coopjz/FOC_Control_Boards/gen2/ELEC3300_DEMO.jpg

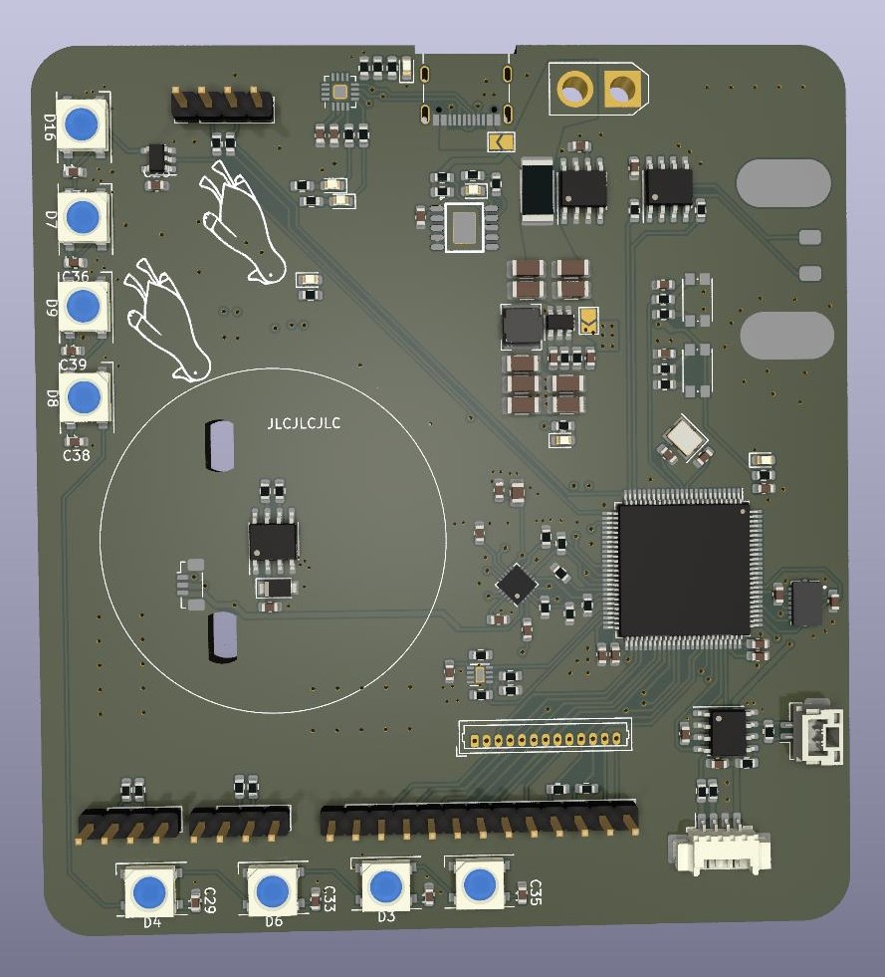
gen2/ELEC3300_DEMO.jpg
