coopjz/FOC_Control_Boards/README.md

# FOC_Control_Boards
1. generation one: g431
2. generation two: f407
- BUGS: BUCK feedback
- BUGS: Hall sensor MISO

## SoftWare
All the firmware :
url{https://github.com/coopjz/ELEC3300-Firmware }

**Author: Ed, Cooper**

**Thanks to:** Ethan, eassse, Jason
