coopjz/FOC_Control_Boards/3finaldemo.pdf

Design Showcase | UI Design | FOC Algorithms | RTOS!

# A FOC Controlled Smart Knob

# WANG Junzhe, ZOU Hetai

## ELEC3300 Group 5

# May 8, 2023

# Design Showcase Schematics and PCB

# UI Design

# FOC Algorithms

# RTOS!

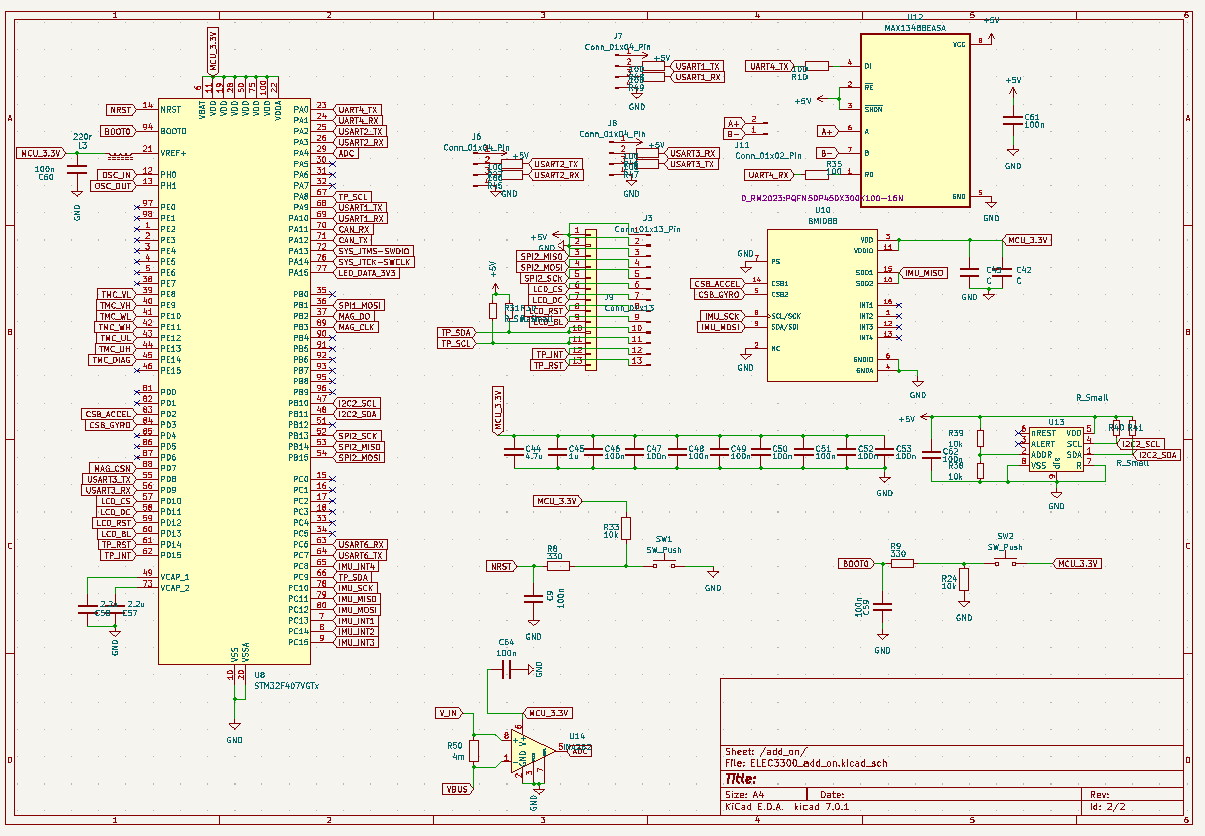
[picture p3: figure]

## Figure: schematic 1

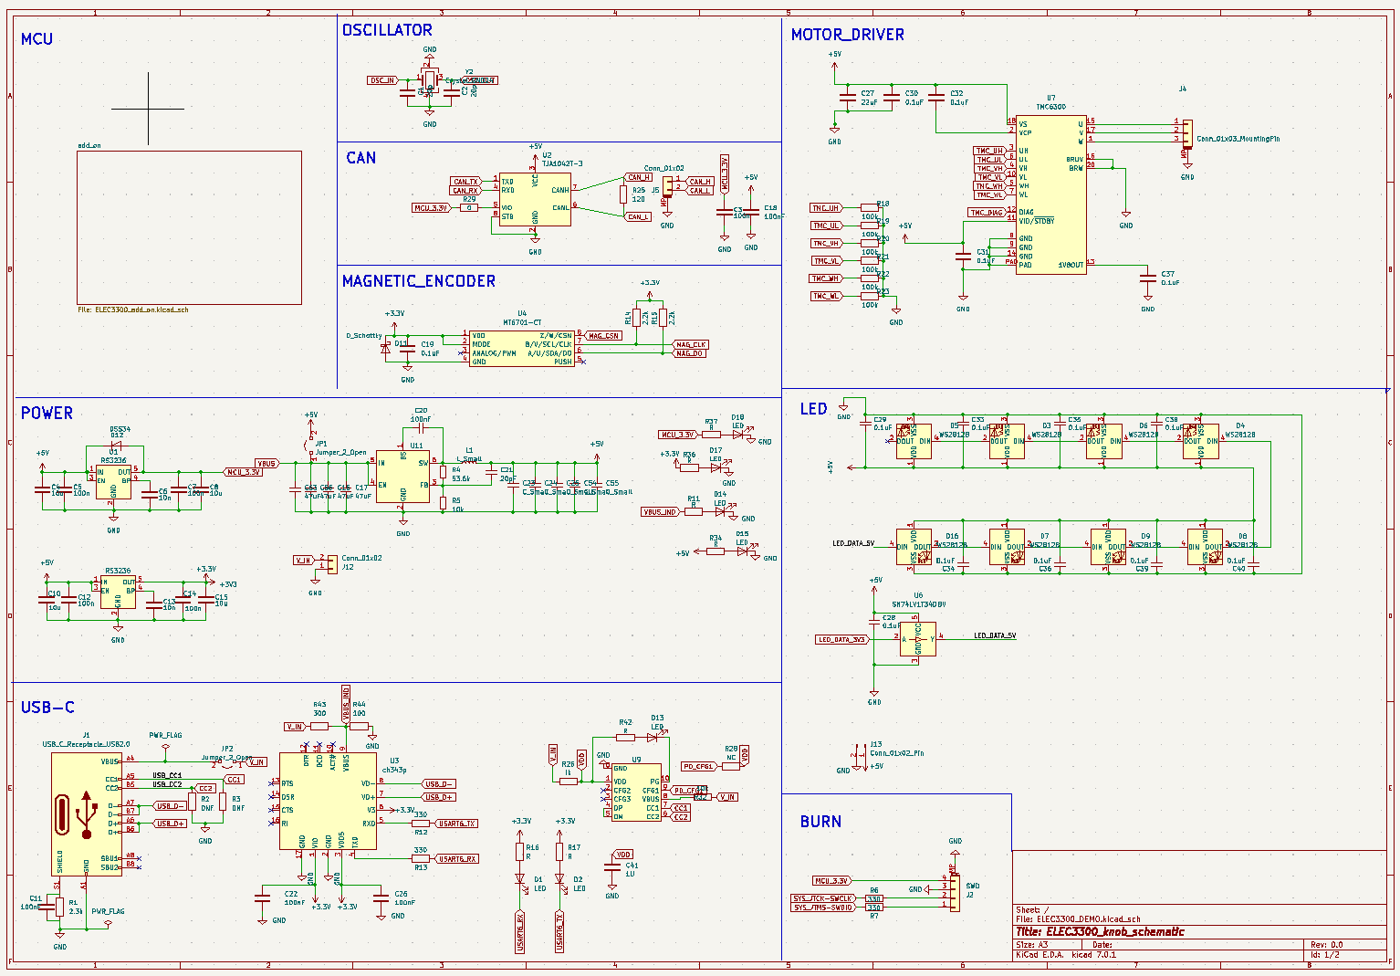
[picture p4: figure]

## Figure: schematic 2

# PCB layout

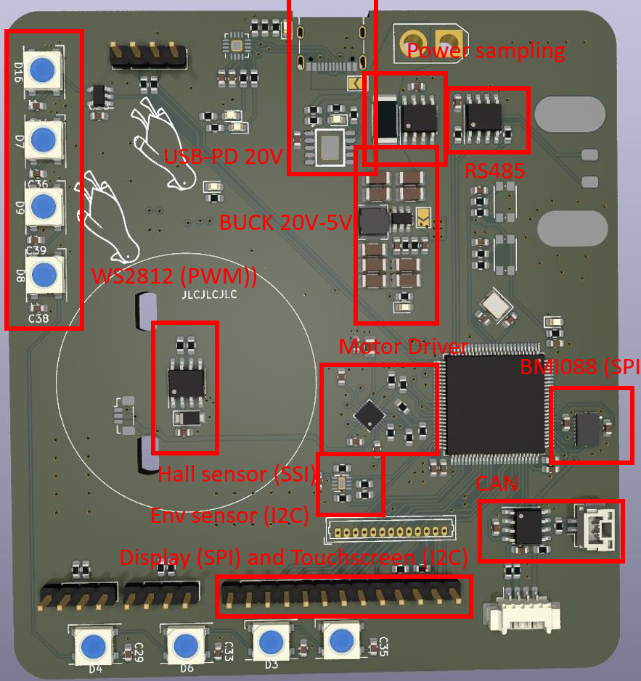
[picture p5: figure]

## Figure: PCB Layout

## •FOC Algorithm Close loop Controlled Motor as knob (Algorithm)

•Magnetic Hall effect sensor feedback | (SPI)
•Brushless DC motor driver | (Half Bridges Driver)
•Implement our own ESC | (SVPWM)
•Bluetooth and usb-ttl controlled | (UART)

## •Usb-C PD power delivery with buck converter (GPIO)

•Power adc sampling | (ADC)
•WS2812 LEDs | (PWM)
•IMU wake detection | (SPI)
•LCD touch screen | (SPI + I2C)
•Smooth and Fast Refresh UI | (Double-Buffer DMA)
•Humidity and Temperature Sensor | (I2C)

# UI Design

# § DMA double buffer to increase frame rate § Async parallel display flush

## § Rendering complete will trigger a callback § DMA will be used to flush to the display afterward

# § LVGL UI elements design

# FOC

# Where is ESC for the knob? We implement our own ESC using Field Oriented Control!

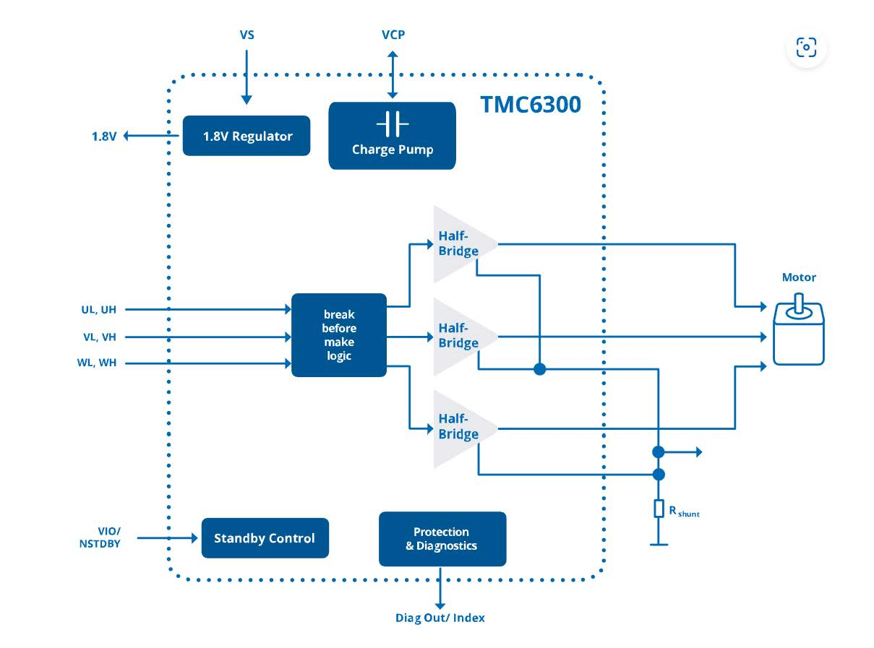
[picture p6: figure]

# Sine PWM (Good)

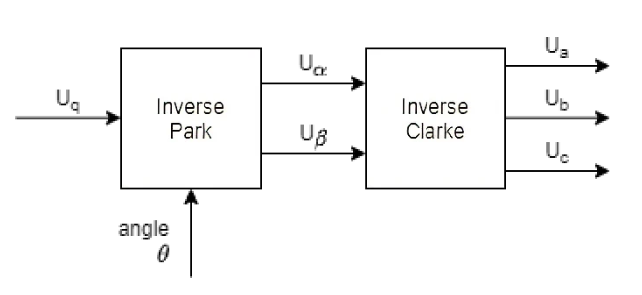
[picture p7: figure]

## Figure: sine pwm

# Sine PWM (Good)

# 1. Inverse Park transformation

# § Uα = ´Uqsin(θ) § Uβ = Uqcos(θ)

# 2. Inverse Clarke transformation

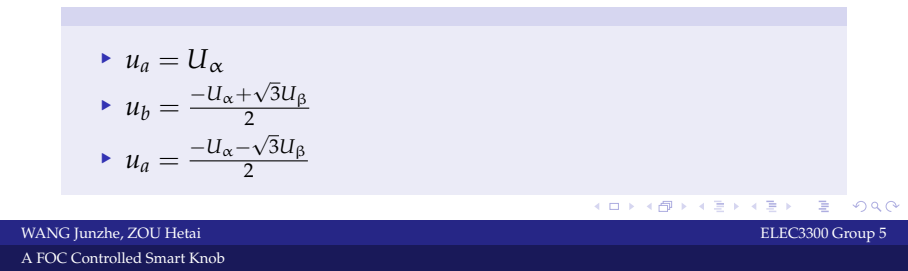
[picture p8: figure]

# to SV PWM (Better)

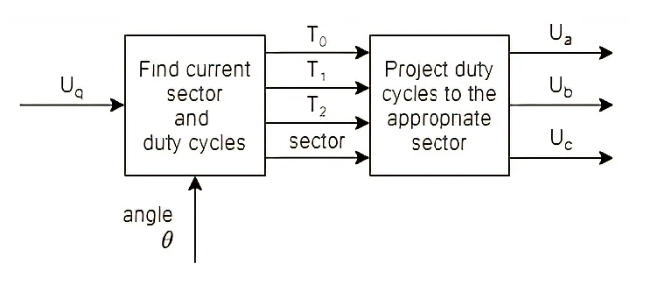
[picture p9: figure]

## Figure: SV pwm

# to SV PWM (Better)

# § space vector modulation

§ s =

X

3
π

\
+ θ

§ T1 =

?

# 3sin(s

3
π ´ θ)

§ T2 =

?

# 3sin(θ ´ (s ´ 1)

3
π

)

## § T0 = 1 ´ T1 ´ T2

# FreeRTOS

# § FreeRTOS to schedule the tasks

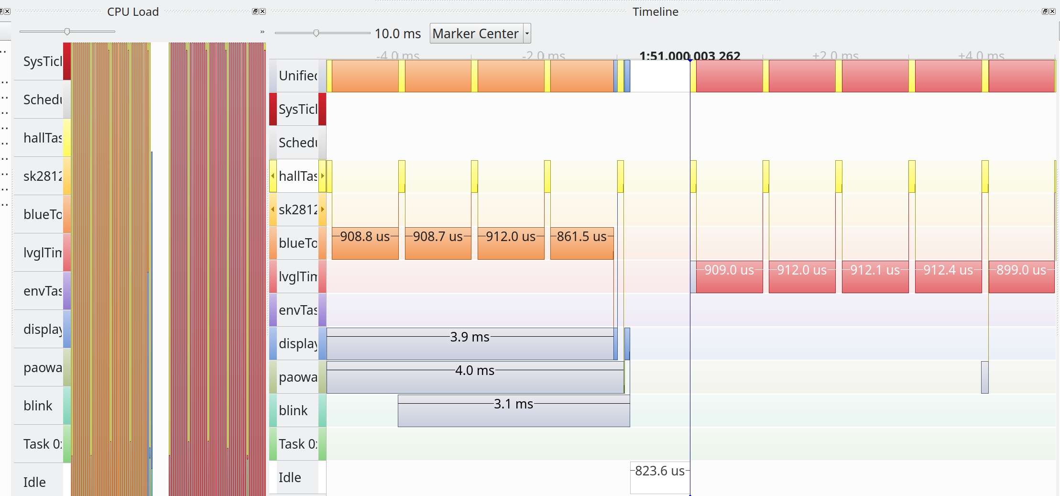
[picture p10: figure]

## Figure: FreeRTOS Scheduler

# That would be all

# - Thank you!
