coopjz/FOC_Control_Boards/gen2/BMI088.step

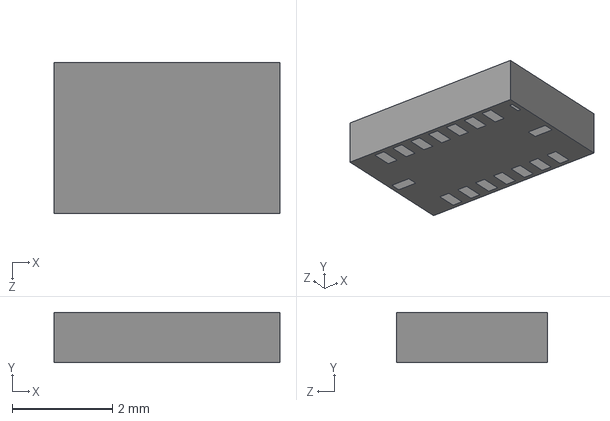
[picture p11: CAD file, 2023-05-09]
gen2/BMI088.step
4.50 x 1.00 x 3.00 mm
