coopjz/FOC_Control_Boards/gen2/MPU-6500/MPU-6500.step

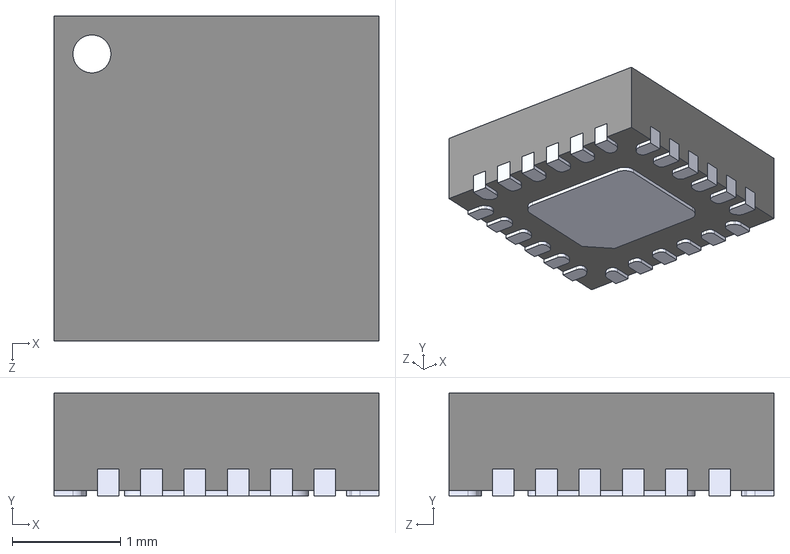
[picture p12: CAD file, 2023-05-09]
gen2/MPU-6500/MPU-6500.step
3.00 x 0.95 x 3.00 mm
