coopjz/FOC_Control_Boards/gen2/ELEC3300_DEMO.kicad_pcb

## KiCad design gen2/ELEC3300_DEMO.kicad_pcb (2023-05-09)

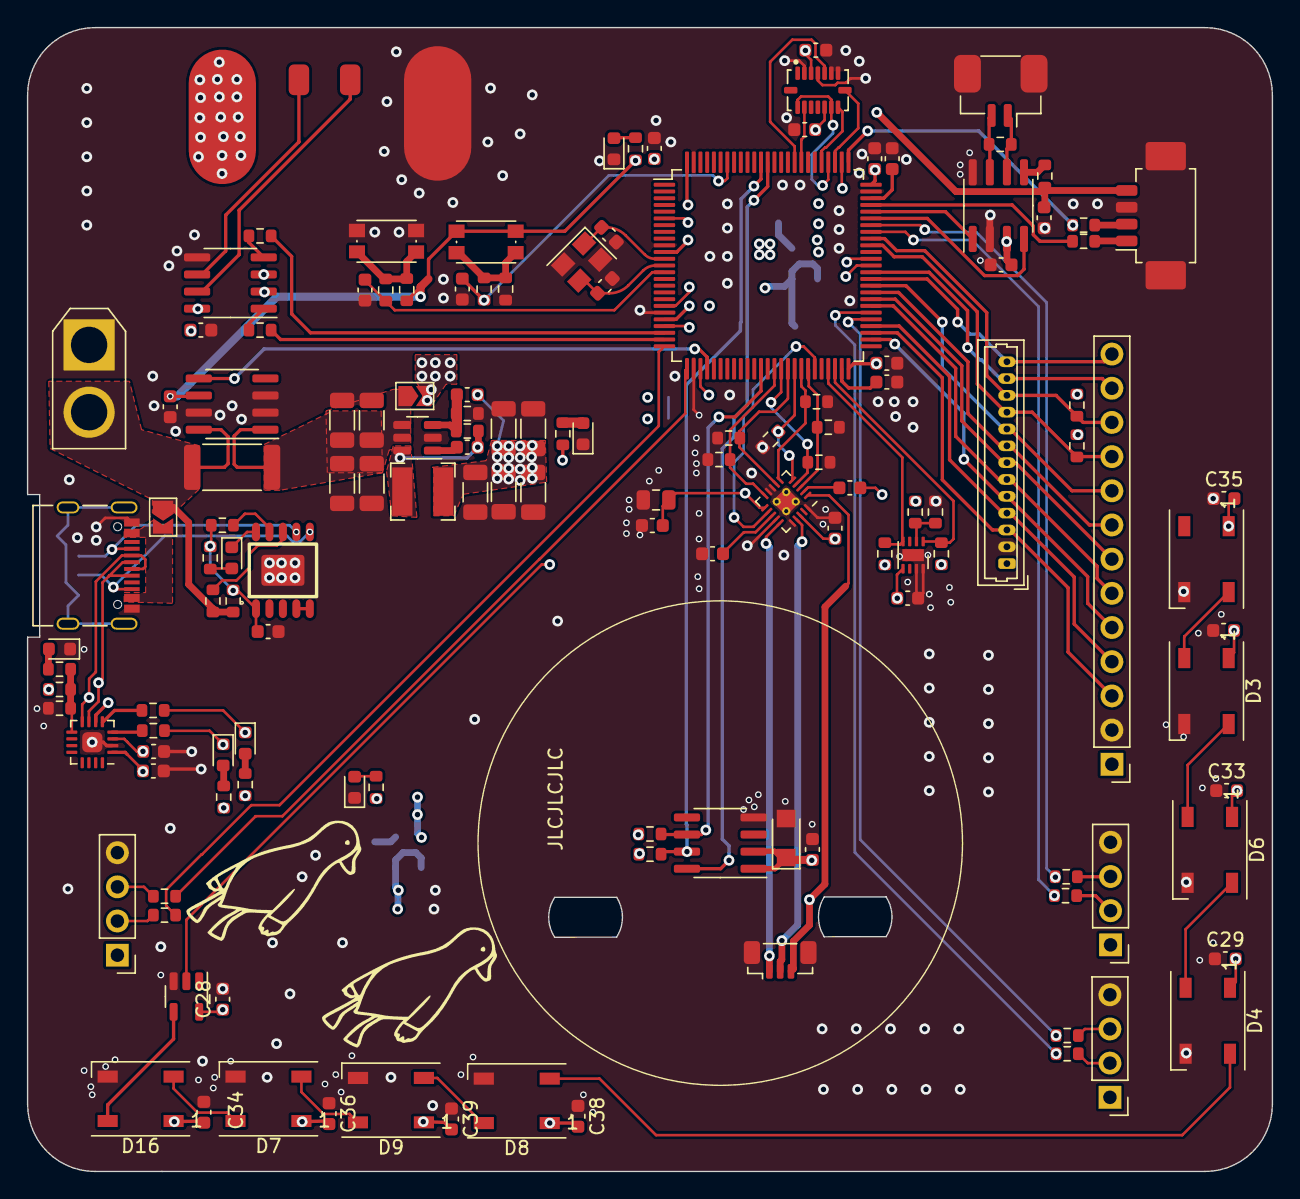
[picture p13: board gen2/ELEC3300_DEMO.kicad_pcb from above]

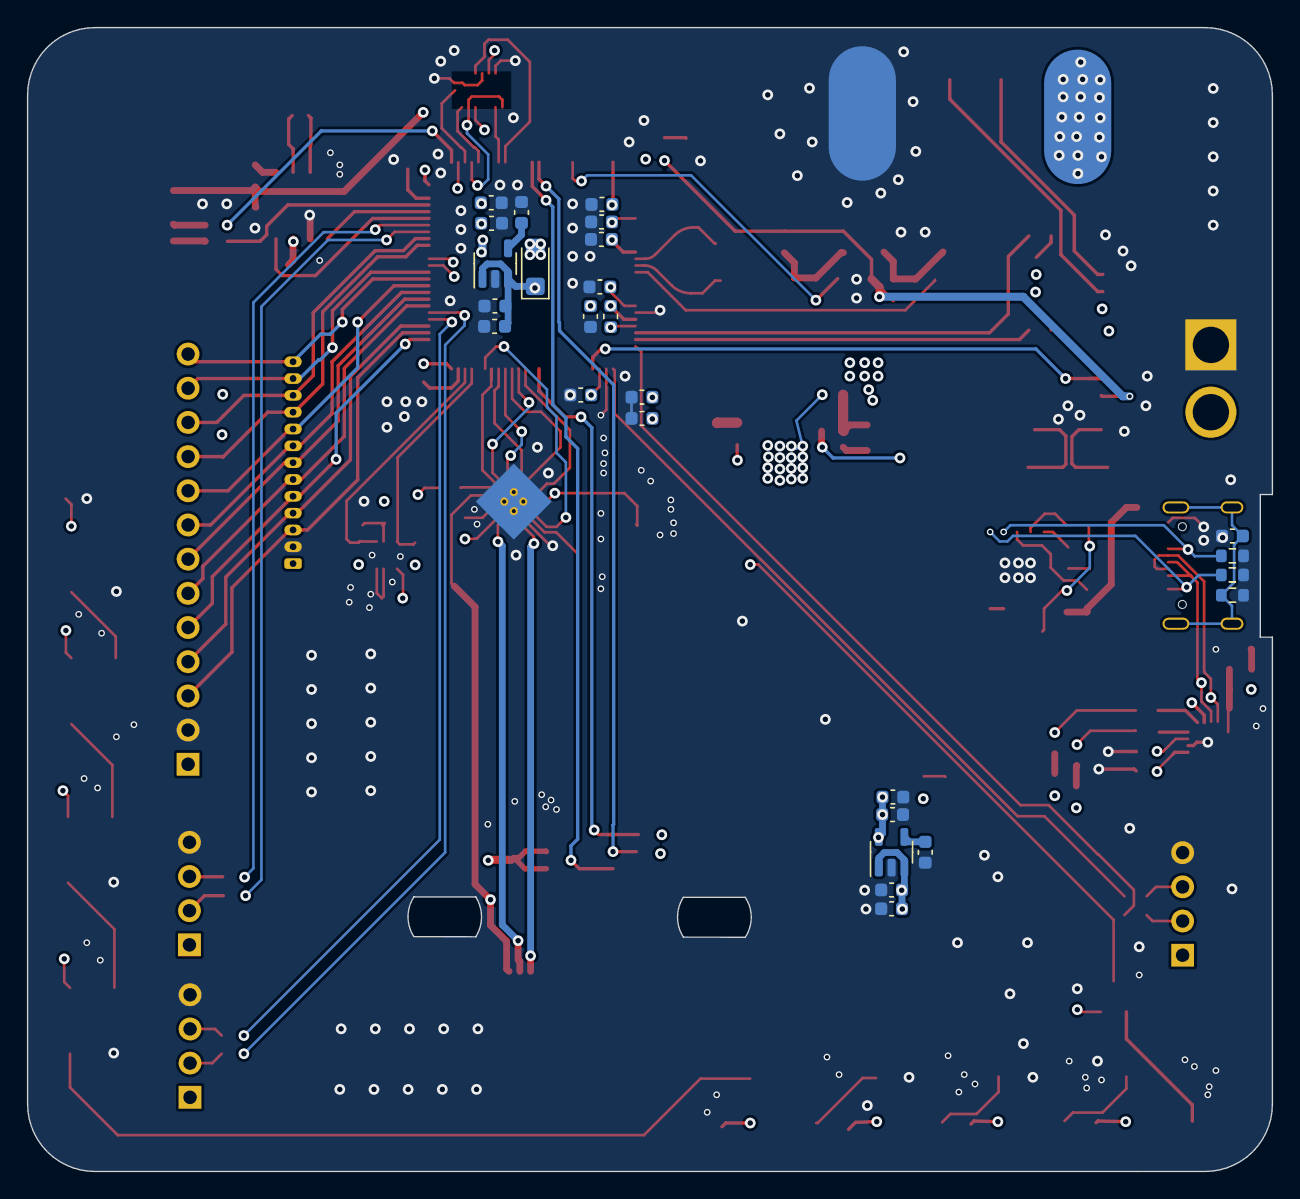
[picture p14: board gen2/ELEC3300_DEMO.kicad_pcb from below]

Board: 4 copper layers, 92.5 x 85.0 mm, 164 parts (26 on the bottom side), 114 nets.

Parts:
C1, C2: 20p; C_0603_1608Metric
C3, C5, C7, C9, C12, C14, C46, C47, C48, C49, C50, C51, C52, C53, C59, C60, C61, C62, C64: 100n; C_0603_1608Metric
C4, C8, C10, C15: 10u; C_0603_1608Metric
C6, C13: 10n; C_0603_1608Metric
C11, C18, C20, C22, C26: 100nF; C_0603_1608Metric
C16, C17, C56, C63: 47uF; C_1206_3216Metric
C19, C28, C29, C30, C31, C32, C33, C34, C35, C36, C37, C38, C39, C40: 0.1uF; C_0603_1608Metric
C21: 20pF; C_0603_1608Metric
C23, C24, C25, C54, C55: C_Small; C_1206_3216Metric
C27: 22uF; C_0805_2012Metric
C41: 1U; C_0603_1608Metric
C42, C43: C; C_0603_1608Metric
C44: 4.7u; C_0603_1608Metric
C45: 1u; C_0603_1608Metric
C57, C58: 2.2u; C_0603_1608Metric
D1, D2, D13, D14, D15, D17, D18: LED; LED_0603_1608Metric
D3, D4, D5, D6, D7, D8, D9, D16: WS2812B; LED_WS2812B_PLCC4_5.0x5.0mm_P3.2mm
D11: D_Schottky; D_SMF
D12: DSS34; D_SMF
J1: USB_C_Receptacle_USB2.0; USB_C_Receptacle_Palconn_UTC16-G
J2: SWD; Molex_PicoBlade_53261-0471_1x04-1MP_P1.25mm_Horizontal
J3: Conn_01x13_Pin; PinHeader_1x13_P2.54mm_Vertical
J4: Conn_01x03_MountingPin; JST_SUR_BM03B-SURS-TF_1x03-1MP_P0.80mm_Vertical
J5: Conn_01x02; GH_1x02
J6, J7, J8: Conn_01x04_Pin; PinHeader_1x04_P2.54mm_Vertical
J9: Conn_01x13; Molex_PicoBlade_53047-1310_1x13_P1.25mm_Vertical
J11: Conn_01x02_Pin; padSmall2
J12: Conn_01x02; AMASS_XT30U-M_1x02_P5.0mm_Vertical
J13: Conn_01x02_Pin; pads2
JP1, JP2: Jumper_2_Open; SolderJumper-2_P1.3mm_Open_TrianglePad1.0x1.5mm
L1: L_Small; L_Bourns-SRN4018
L3: 220r; L_0603_1608Metric
R1: 2.3k; R_0603_1608Metric
R2, R3: 5.1k; R_0603_1608Metric
R4: 53.6k; R_0603_1608Metric
R5, R24, R32, R33, R38, R39: 10k; R_0603_1608Metric
R6, R7, R8, R9, R12, R13: 330; R_0603_1608Metric
R10, R27, R35, R44, R45, R46, R47, R48, R49: 100; R_0603_1608Metric
R11, R16, R17, R34, R36, R37, R42: R; R_0603_1608Metric
R14, R15: 2.2k; R_0603_1608Metric
R18, R19, R20, R21, R22, R23: 100k; R_0603_1608Metric
R25: 120; R_0603_1608Metric
R26: Ik; R_0603_1608Metric
R28: NC; R_0603_1608Metric
R29: 0; R_0603_1608Metric
R30, R31, R40, R41: R_Small; R_0603_1608Metric
R43: 300; R_0603_1608Metric
R50: 4m; R_2512_6332Metric
SW1, SW2: SW_Push; SW_Push_1P1T_NO_CK_KMR2
U1, U5: RS3236; SOT-23-5
U2: TJA1042T-3; SOIC-8_3.9x4.9mm_P1.27mm
U3: ch343p; QFN-16-1EP_3x3mm_P0.5mm_EP1.7x1.7mm
U4: MT6701-CT; SOIC-8_3.9x4.9mm_P1.27mm
U6: SN74LV1T34DBV; SOT-23-5
U7: TMC6300; QFN-20-1EP_3x3mm_P0.4mm_EP1.65x1.65mm_ThermalVias_LargerVia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
U8: STM32F407VGTx; LQFP-100_14x14mm_P0.5mm
U9: ESSOP-10
U10: BMI088; PQFN50P450X300X100-16N
U11: SOT-23-6
U12: MAX13488EASA; SOIC-8_3.9x4.9mm_P1.27mm
U13: DFN-8-1EP_2x2mm_P0.5mm_EP0.9x1.6mm
U14: INA282; SOIC-8_3.9x4.9mm_P1.27mm
Y2: Crystal_GND24; Crystal_SMD_3225-4Pin_3.2x2.5mm

Connections:
+3.3V: C14.1, C15.1, C19.1, C22.1, C26.1, D11.1 (K), R14.2, R15.2, R16.2, R17.2, R36.1, U3.1 (VIO), U3.3 (VDD5), U3.6 (V3), U4.1 (VDD), U4.2 (MODE), U5.5 (OUT)
+5V: C4.1, C5.1, C10.1, C12.1, C18.1, C21.2, C23.2, C24.2, C25.2, C27.1, C28.1, C29.2, C30.1, C31.1, C32.1, C33.2, C34.2, C35.2, C36.2, C38.2, C39.2, C40.2, C54.2, C55.2, C61.1, C62.1, D3.1 (VDD), D4.1 (VDD), D5.1 (VDD), D6.1 (VDD), D7.1 (VDD), D8.1 (VDD), D9.1 (VDD), D12.1 (K), D16.1 (VDD), J3.1, J6.1, J7.1, J8.1, J9.1, J13.1, JP1.2 (B), L1.2, R30.1, R31.1, R34.1, R39.2, R40.1, R41.1, U1.1 (IN), U1.3 (EN), U2.3 (VCC), U5.1 (IN), U5.3 (EN), U6.5 (VCC), U7.11 (VIO/~STDBY), U7.18 (VS), U12.2 (~RE), U12.3 (~SHDN), U12.8 (VCC), U13.5 (VDD)
/LED_DATA_5V: D16.4 (DIN), U6.4 (Y)
A+: J11.2, U12.6 (A)
ADC: U8.29 (PA4), U14.5
B-: J11.1, U12.7 (B)
BOOT0: C59.1, R9.2, U8.94 (BOOT0)
CAN_H: J5.1, R25.1, U2.7 (CANH)
CAN_L: J5.2, R25.2, U2.6 (CANL)
CAN_RX: U2.4 (RXD), U8.70 (PA11)
CAN_TX: U2.1 (TXD), U8.71 (PA12)
CC1: J1.A5 (CC1), R3.1, U9.7 (CC1)
CC2: J1.B5 (CC2), R2.1, U9.6 (CC2)
CSB_ACCEL: U8.83 (PD2), U10.14 (CSB1)
CSB_GYRO: U8.84 (PD3), U10.5 (CSB2)
GND: C1.1, C2.1, C3.2, C4.2, C5.2, C6.2, C7.2, C8.2, C9.1, C10.2, C11.2, C12.2, C13.2, C14.2, C15.2, C16.1, C17.1, C18.2, C19.2, C22.2, C23.1, C24.1, C25.1, C26.2, C27.2, C28.2, C29.1, C30.2, C31.2, C33.1, C34.1, C35.1, C36.1, C37.2, C38.1, C39.1, C40.1, C41.2, C42.1, C43.1, C44.2, C45.2, C46.2, C47.2, C48.2, C49.2, C50.2, C51.2, C52.2, C53.2, C54.1, C55.1, C56.1, C57.1, C58.1, C59.2, C60.1, C61.2, C62.2, C63.1, C64.2, D3.3 (VSS), D4.3 (VSS), D5.3 (VSS), D6.3 (VSS), D7.3 (VSS), D8.3 (VSS), D9.3 (VSS), D11.2 (A), D14.1 (K), D15.1 (K), D16.3 (VSS), D17.1 (K), D18.1 (K), J1.A1 (GND), J1.A12 (GND), J1.B1 (GND), J1.B12 (GND), J2.3, J2.MP (MountPin), J3.2, J4.MP (MountPin), J5.MP (MountPin), J6.4, J7.4, J8.4, J9.2, J12.1, J13.2, R1.2, R2.2, R3.2, R5.2, R18.2, R19.2, R20.2, R21.2, R22.2, R23.2, R24.2, R38.1, R44.2, SW1.2, U1.2 (GND), U2.2 (GND), U2.8 (STB), U3.2 (GND), U3.17 (GND), U4.4 (GND), U5.2 (GND), U6.3 (GND), U7.8 (GND), U7.9 (GND), U7.14 (GND), U7.16 (BRUV), U7.20 (BRW), U7.PAD, U8.10 (VSS), U8.20 (VSSA), U8.27 (VSS), U8.74 (VSS), U8.99 (VSS), U9.0 (GND), U10.2 (NC), U10.4 (GNDA), U10.6 (GNDIO), U10.7 (PS), U11.2 (GND), U12.5 (GND), U13.7 (R), U13.8 (VSS), U13.9 (die), U14.2 (GND), U14.3 (REF2), U14.7 (REF1), Y2.2, Y2.4
I2C2_SCL: R40.2, U8.47 (PB10), U13.4 (SCL)
I2C2_SDA: R41.2, U8.48 (PB11), U13.1 (SDA)
IMU_MISO: U8.79 (PC11), U10.10 (SDO2), U10.15 (SDO1)
IMU_MOSI: U8.80 (PC12), U10.9 (SDA/SDI)
IMU_SCK: U8.78 (PC10), U10.8 (SCL/SCK)
LCD_BL: J3.9, J9.9, U8.60 (PD13)
LCD_CS: J3.6, J9.6, U8.57 (PD10)
LCD_DC: J3.7, J9.7, U8.58 (PD11)
LCD_RST: J3.8, J9.8, U8.59 (PD12)
LED_DATA_3V3: U6.2 (A), U8.77 (PA15)
MAG_CLK: R14.1, U4.7 (B/V/SCL/CLK), U8.89 (PB3)
MAG_CSN: U4.8 (Z/W/CSN), U8.88 (PD7)
MAG_DO: R15.1, U4.6 (A/U/SDA/DO), U8.37 (PB2)
MCU_3.3V: C3.1, C7.1, C8.1, C42.2, C43.2, C44.1, C45.1, C46.1, C47.1, C48.1, C49.1, C50.1, C51.1, C52.1, C53.1, C60.2, C64.1, D12.2 (A), J2.4, L3.2, R29.1, R33.1, R37.1, SW2.2, U1.5 (OUT), U8.6 (VBAT), U8.11 (VDD), U8.19 (VDD), U8.22 (VDDA), U8.28 (VDD), U8.50 (VDD), U8.75 (VDD), U8.100 (VDD), U10.3 (VDD), U10.11 (VDDIO), U14.6 (V+)
NRST: C9.2, R8.2, U8.14 (NRST)
unnamed: D1.2 (A), R16.1
unnamed: D2.2 (A), R17.1
unnamed: D3.4 (DIN), D6.2 (DOUT)
unnamed: D3.2 (DOUT), D5.4 (DIN)
unnamed: D4.4 (DIN), D8.2 (DOUT)
unnamed: D4.2 (DOUT), D6.4 (DIN)
unnamed: D7.2 (DOUT), D9.4 (DIN)
unnamed: D8.4 (DIN), D9.2 (DOUT)
unnamed: D13.2 (A), R42.2
unnamed: D13.1 (K), U9.10 (PG)
unnamed: D14.2 (A), R11.2
unnamed: D15.2 (A), R34.2
unnamed: D7.4 (DIN), D16.2 (DOUT)
unnamed: D17.2 (A), R36.2
unnamed: D18.2 (A), R37.2
unnamed: C11.1, J1.S1 (SHIELD), R1.1
unnamed: J2.1, R7.2
unnamed: J2.2, R6.2
unnamed: J4.1, U7.15 (U)
unnamed: J4.2, U7.17 (V)
unnamed: J4.3, U7.1 (W)
unnamed: J6.2, R27.2
unnamed: J6.3, R45.2
unnamed: J7.2, R48.2
unnamed: J7.3, R49.2
unnamed: J8.2, R46.2
unnamed: J8.3, R47.2
unnamed: J1.A4 (VBUS), J1.A9 (VBUS), J1.B4 (VBUS), J1.B9 (VBUS), JP2.2 (B)
unnamed: R9.1, R24.1, SW2.1
unnamed: R8.1, R33.2, SW1.1
unnamed: C6.1, U1.4 (BP)
unnamed: R29.2, U2.5 (VIO)
unnamed: R12.1, U3.5 (RXD)
unnamed: R13.1, U3.4 (TXD)
unnamed: C13.1, U5.4 (BP)
unnamed: C37.1, U7.13 (1V8OUT)
unnamed: C32.2, U7.2 (VCP)
unnamed: C58.2, U8.49 (VCAP_1)
unnamed: C57.2, U8.73 (VCAP_2)
unnamed: L3.1, U8.21 (VREF+)
unnamed: U9.4 (DP), U9.5 (DM)
unnamed: R32.1, U9.8 (VBUS)
unnamed: C20.1, U11.1 (BS)
unnamed: C21.1, R4.2, R5.1, U11.3 (FB)
unnamed: C20.2, L1.1, R4.1, U11.6 (SW)
unnamed: R10.1, U12.4 (DI)
unnamed: R35.2, U12.1 (RO)
unnamed: R38.2, R39.1, U13.2 (ADDR)
OSC_IN: C1.2, U8.12 (PH0), Y2.1
OSC_OUT: C2.2, U8.13 (PH1), Y2.3
PD_CFG1: R28.2, U9.9 (CFG1)
SPI2_MISO: J3.3, J9.3, U8.53 (PB14)
SPI2_MOSI: J3.4, J9.4, U8.54 (PB15)
SPI2_SCK: J3.5, J9.5, U8.52 (PB13)
SYS_JTCK-SWCLK: R6.1, U8.76 (PA14)
SYS_JTMS-SWDIO: R7.1, U8.72 (PA13)
TMC_DIAG: U7.12 (DIAG), U8.45 (PE14)
TMC_UH: R18.1, U7.3 (UH), U8.44 (PE13)
TMC_UL: R19.1, U7.6 (UL), U8.43 (PE12)
TMC_VH: R20.1, U7.4 (VH), U8.40 (PE9)
TMC_VL: R21.1, U7.10 (VL), U8.39 (PE8)
TMC_WH: R22.1, U7.5 (WH), U8.42 (PE11)
TMC_WL: R23.1, U7.7 (WL), U8.41 (PE10)
TP_INT: J3.12, J9.12, U8.62 (PD15)
TP_RST: J3.13, J9.13, U8.61 (PD14)
TP_SCL: J3.11, J9.11, R31.2, U8.67 (PA8)
TP_SDA: J3.10, J9.10, R30.2, U8.66 (PC9)
UART4_RX: R35.1, U8.24 (PA1)
UART4_TX: R10.2, U8.23 (PA0)
USART1_RX: R49.1, U8.69 (PA10)
USART1_TX: R48.1, U8.68 (PA9)
USART2_RX: R45.1, U8.26 (PA3)
USART2_TX: R27.1, U8.25 (PA2)
USART3_RX: R46.1, U8.56 (PD9)
USART3_TX: R47.1, U8.55 (PD8)
USART6_RX: D1.1 (K), R13.2, U8.63 (PC6)
USART6_TX: D2.1 (K), R12.2, U8.64 (PC7)
USB_D+: J1.A6 (D+), J1.B6 (D+), U3.7 (VD+)
USB_D-: J1.A7 (D-), J1.B7 (D-), U3.8 (VD-)
VBUS: C16.2, C17.2, C56.2, C63.2, JP1.1 (A), R50.2, U11.4 (EN), U11.5 (IN), U14.1 (-)
VBUS_IND: R11.1, R43.2, R44.1, U3.9 (VBUS)
VDD: C41.1, R26.1, R28.1, R42.1, U9.1 (VDD)
V_IN: J12.2, JP2.1 (A), R26.2, R32.2, R43.1, R50.1, U14.8 (+)
