coopjz/FOC_Control_Boards/gen1/ELEC3300_DEMO.kicad_pcb

## KiCad design gen1/ELEC3300_DEMO.kicad_pcb (2023-05-09, an earlier design)

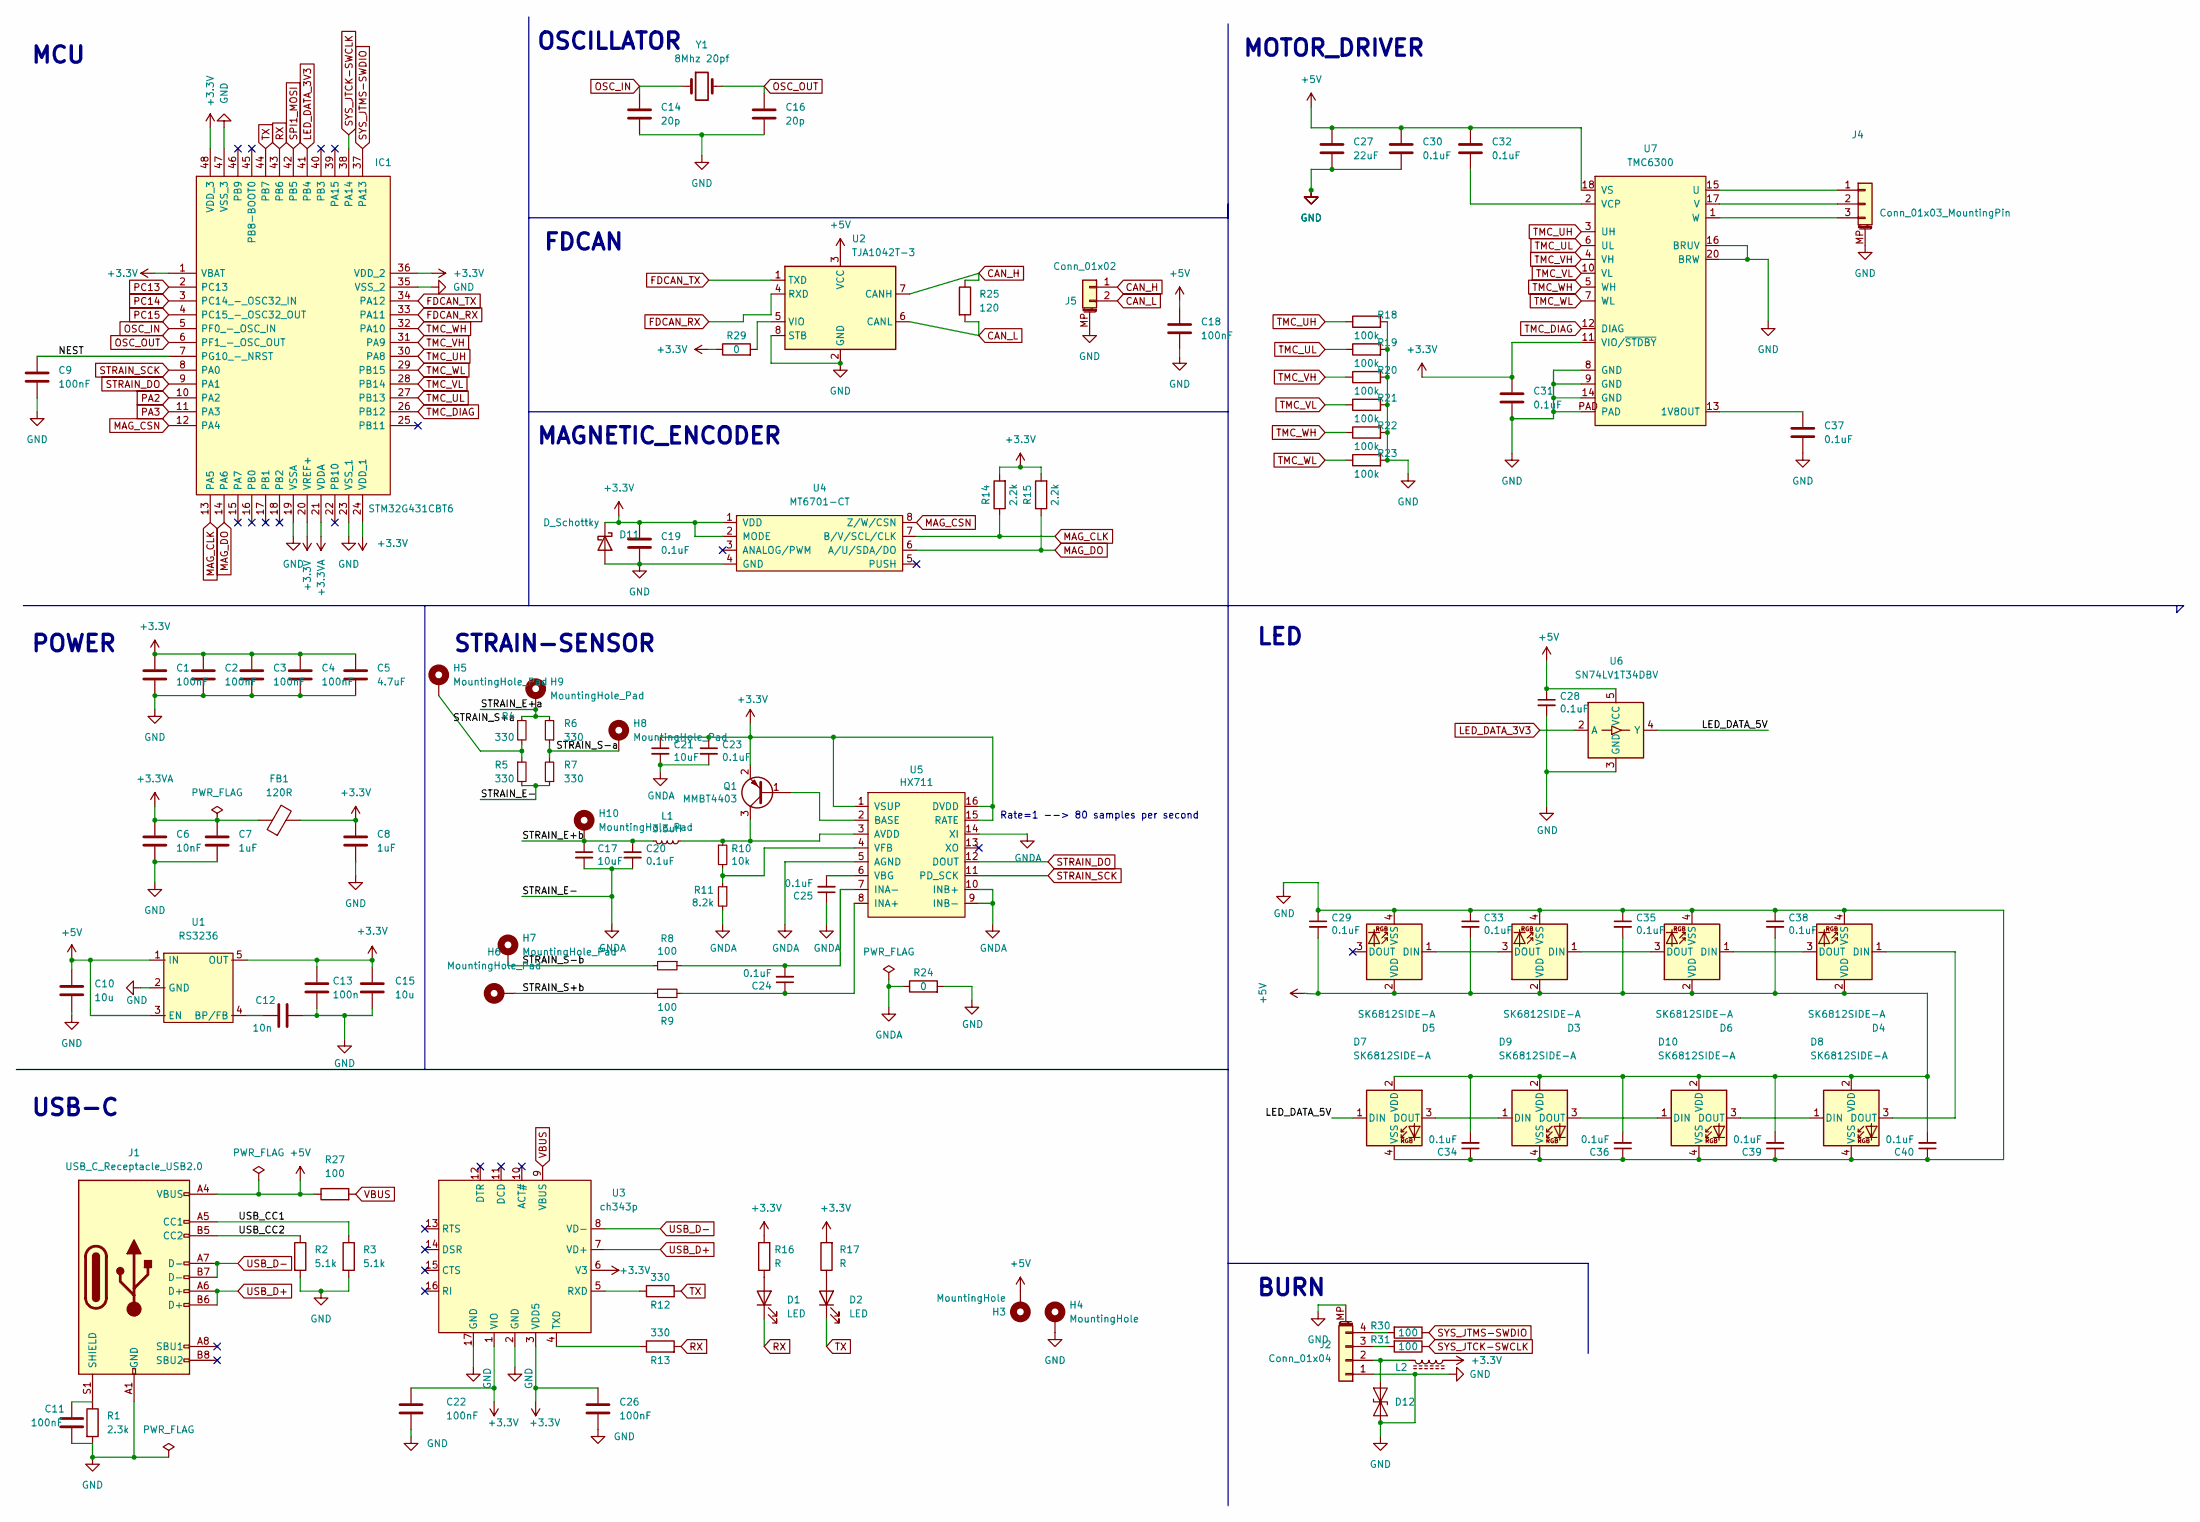
[picture p15: schematic ELEC3300_DEMO.kicad_sch, ELEC3300_knob_schematic]

Parts:
C1, C2, C3, C4, C9, C11, C18, C22, C26: 100nF; C_0603_1608Metric
C5: 4.7uF; C_0603_1608Metric
C6: 10nF; C_0603_1608Metric
C7, C8: 1uF; C_0603_1608Metric
C10, C15: 10u; C_0603_1608Metric
C12: 10n; C_0603_1608Metric
C13: 100n; C_0603_1608Metric
C14, C16: 20p; C_0603_1608Metric
C17, C21: 10uF; C_0603_1608Metric; LCSC C2922480
C19, C30, C31, C32, C37: 0.1uF; C_0603_1608Metric
C20, C23, C24, C25, C28, C29, C33, C34, C35, C36, C38, C39, C40: 0.1uF; C_0603_1608Metric; LCSC C1591
C27: 22uF; C_0805_2012Metric
D1, D2: LED; LED_0603_1608Metric
D3, D4, D5, D6, D7, D8, D9, D10: SK6812SIDE-A; LED_SK6812MINI_PLCC4_3.5x3.5mm_P1.75mm; Digikey 1528-4691-ND
D11: D_Schottky; D_SMF
D12: ESD9B3.3ST5G; D_SOD-123F
FB1: 120R; L_0603_1608Metric
H3, H4: MountingHole; solder_spot
H5, H6, H7, H8, H9, H10: MountingHole_Pad; pad
IC1: STM32G431CBT6; LQFP-48_7x7mm_P0.5mm; Manufacturer_Part_Number STM32G431CBT6; Mouser Part Number 511-STM32G431CBT6
J1: USB_C_Receptacle_USB2.0; USB_C_Receptacle_Palconn_UTC16-G
J2: Conn_01x04; Molex_PicoBlade_53261-0471_1x04-1MP_P1.25mm_Horizontal
J4: Conn_01x03_MountingPin; JST_SUR_BM03B-SURS-TF_1x03-1MP_P0.80mm_Vertical
J5: Conn_01x02; GH_1x02
L1: 3.3uH; L_0805_2012Metric; LCSC C307744
L2: L_Ferrite; L_0603_1608Metric
Q1: MMBT4403; SOT-23; LCSC C78864
R1: 2.3k; R_0603_1608Metric
R2, R3: 5.1k; R_0603_1608Metric
R4, R5, R6, R7: 330; R_2512_6332Metric; LCSC C19866
R8, R9: 100; R_0603_1608Metric; LCSC C319953
R10: 10k; R_0603_1608Metric; LCSC C98220
R11: 8.2k; R_0603_1608Metric; LCSC C114637
R12, R13: 330; R_0603_1608Metric
R14, R15: 2.2k; R_0603_1608Metric
R16, R17: R; R_0603_1608Metric
R18, R19, R20, R21, R22, R23: 100k; R_0603_1608Metric
R24, R29: 0; R_0603_1608Metric
R25: 120; R_0603_1608Metric
R27, R30, R31: 100; R_0603_1608Metric
U1: RS3236; SOT-23-5
U2: TJA1042T-3; SOIC-8_3.9x4.9mm_P1.27mm
U3: ch343p; QFN-16-1EP_3x3mm_P0.5mm_EP1.7x1.7mm
U4: MT6701-CT; SOIC-8_3.9x4.9mm_P1.27mm
U5: HX711; SOIC-16_3.9x9.9mm_P1.27mm; LCSC C43656
U6: SN74LV1T34DBV; SOT-23-5; LCSC C100024
U7: TMC6300; QFN-20-1EP_3x3mm_P0.4mm_EP1.65x1.65mm_ThermalVias_LargerVia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
Y1: 8Mhz 20pf; Crystal_SMD_5032-2Pin_5.0x3.2mm_HandSoldering

Connections:
+3.3VA: C6.1, C7.1, FB1.1, IC1.21 (VDDA)
+3V3: C1.1, C2.1, C3.1, C4.1, C5.1, C8.1, C13.1, C15.1, C19.1, C21.1, C22.1, C23.1, C26.1, C31.1, D11.1 (K), FB1.2, IC1.1 (VBAT), IC1.20 (VREF+), IC1.24 (VDD_1), IC1.36 (VDD_2), IC1.48 (VDD_3), L2.1, Q1.2 (E), R14.2, R15.2, R16.2, R17.2, R29.1, U1.5 (OUT), U3.1 (VIO), U3.3 (VDD5), U3.6 (V3), U4.1 (VDD), U4.2 (MODE), U5.1 (VSUP), U5.15 (RATE), U5.16 (DVDD), U7.11 (VIO/~STDBY)
+5V: C10.1, C18.1, C27.1, C28.1, C29.2, C30.1, C32.1, C33.2, C34.2, C35.2, C36.2, C38.2, C39.2, C40.2, D3.2 (VDD), D4.2 (VDD), D5.2 (VDD), D6.2 (VDD), D7.2 (VDD), D8.2 (VDD), D9.2 (VDD), D10.2 (VDD), H3.1, J1.A4 (VBUS), J1.A9 (VBUS), J1.B4 (VBUS), J1.B9 (VBUS), R27.1, U1.1 (IN), U1.3 (EN), U2.3 (VCC), U6.5 (VCC), U7.18 (VS)
/LED_DATA_5V: D7.1 (DIN), U6.4 (Y)
/NEST: C9.1, IC1.7 (PG10_-_NRST)
/STRAIN_E+a: H9.1, R4.1, R6.2
/STRAIN_E+b: C17.1, C20.1, H10.1, L1.2
/STRAIN_S+b: H6.1, R9.1
/STRAIN_S-a: H8.1, R6.1, R7.2
/STRAIN_S-b: H7.1, R8.2
/USB_CC1: J1.A5 (CC1), R3.1
/USB_CC2: J1.B5 (CC2), R2.1
CAN_H: J5.1, R25.1, U2.7 (CANH)
CAN_L: J5.2, R25.2, U2.6 (CANL)
FDCAN_RX: IC1.33 (PA11), U2.4 (RXD)
FDCAN_TX: IC1.34 (PA12), U2.1 (TXD)
GND: C1.2, C2.2, C3.2, C4.2, C5.2, C6.2, C7.2, C8.2, C9.2, C10.2, C11.2, C12.2, C13.2, C14.2, C15.2, C16.2, C18.2, C19.2, C22.2, C26.2, C27.2, C28.2, C29.1, C30.2, C31.2, C33.1, C34.1, C35.1, C36.1, C37.2, C38.1, C39.1, C40.1, D3.4 (VSS), D4.4 (VSS), D5.4 (VSS), D6.4 (VSS), D7.4 (VSS), D8.4 (VSS), D9.4 (VSS), D10.4 (VSS), D11.2 (A), D12.1 (A1), H4.1, IC1.19 (VSSA), IC1.23 (VSS_1), IC1.35 (VSS_2), IC1.47 (VSS_3), J1.A1 (GND), J1.A12 (GND), J1.B1 (GND), J1.B12 (GND), J2.1, J2.MP (MountPin), J4.MP (MountPin), J5.MP (MountPin), R1.2, R2.2, R3.2, R18.2, R19.2, R20.2, R21.2, R22.2, R23.2, R24.2, U1.2 (GND), U2.2 (GND), U2.8 (STB), U3.2 (GND), U3.17 (GND), U4.4 (GND), U6.3 (GND), U7.8 (GND), U7.9 (GND), U7.14 (GND), U7.16 (BRUV), U7.20 (BRW), U7.PAD
GNDA: C17.2, C20.2, C21.2, C23.2, C25.1, R5.2, R7.1, R11.2, R24.1, U5.5 (AGND), U5.9 (INB-), U5.10 (INB+), U5.14 (XI)
LED_DATA_3V3: IC1.41 (PB4), U6.2 (A)
MAG_CLK: IC1.13 (PA5), R14.1, U4.7 (B/V/SCL/CLK)
MAG_CSN: IC1.12 (PA4), U4.8 (Z/W/CSN)
MAG_DO: IC1.14 (PA6), R15.1, U4.6 (A/U/SDA/DO)
unnamed: C11.1, J1.S1 (SHIELD), R1.1
unnamed: C12.1, U1.4 (BP/FB)
unnamed: C24.1, R9.2, U5.8 (INA+)
unnamed: C24.2, R8.1, U5.7 (INA-)
unnamed: C25.2, U5.6 (VBG)
unnamed: C32.2, U7.2 (VCP)
unnamed: C37.1, U7.13 (1V8OUT)
unnamed: D1.2 (A), R16.1
unnamed: D2.2 (A), R17.1
unnamed: D3.1 (DIN), D6.3 (DOUT)
unnamed: D3.3 (DOUT), D5.1 (DIN)
unnamed: D4.1 (DIN), D8.3 (DOUT)
unnamed: D4.3 (DOUT), D6.1 (DIN)
unnamed: D7.3 (DOUT), D9.1 (DIN)
unnamed: D9.3 (DOUT), D10.1 (DIN)
unnamed: D8.1 (DIN), D10.3 (DOUT)
unnamed: D12.2 (A2), J2.2, L2.2
unnamed: J2.3, R31.2
unnamed: J2.4, R30.2
unnamed: J4.1, U7.15 (U)
unnamed: J4.2, U7.17 (V)
unnamed: J4.3, U7.1 (W)
unnamed: L1.1, Q1.3 (C), R10.1, U5.3 (AVDD)
unnamed: Q1.1 (B), U5.2 (BASE)
unnamed: H5.1, R4.2, R5.1
unnamed: R10.2, R11.1, U5.4 (VFB)
unnamed: R12.1, U3.5 (RXD)
unnamed: R13.1, U3.4 (TXD)
unnamed: R29.2, U2.5 (VIO)
OSC_IN: C14.1, IC1.5 (PF0_-_OSC_IN), Y1.1
OSC_OUT: C16.1, IC1.6 (PF1_-_OSC_OUT), Y1.2
PA2: IC1.10 (PA2)
PA3: IC1.11 (PA3)
PC13: IC1.2 (PC13)
PC14: IC1.3 (PC14_-_OSC32_IN)
PC15: IC1.4 (PC15_-_OSC32_OUT)
RX: D1.1 (K), IC1.43 (PB6), R13.2
SPI1_MOSI: IC1.42 (PB5)
STRAIN_DO: IC1.9 (PA1), U5.12 (DOUT)
STRAIN_SCK: IC1.8 (PA0), U5.11 (PD_SCK)
SYS_JTCK-SWCLK: IC1.38 (PA14), R31.1
SYS_JTMS-SWDIO: IC1.37 (PA13), R30.1
TMC_DIAG: IC1.26 (PB12), U7.12 (DIAG)
TMC_UH: IC1.30 (PA8), R18.1, U7.3 (UH)
TMC_UL: IC1.27 (PB13), R19.1, U7.6 (UL)
TMC_VH: IC1.31 (PA9), R20.1, U7.4 (VH)
TMC_VL: IC1.28 (PB14), R21.1, U7.10 (VL)
TMC_WH: IC1.32 (PA10), R22.1, U7.5 (WH)
TMC_WL: IC1.29 (PB15), R23.1, U7.7 (WL)
TX: D2.1 (K), IC1.44 (PB7), R12.2
USB_D+: J1.A6 (D+), J1.B6 (D+), U3.7 (VD+)
USB_D-: J1.A7 (D-), J1.B7 (D-), U3.8 (VD-)
VBUS: R27.2, U3.9 (VBUS)

Notes on the sheet:
USB-C
MAGNETIC_ENCODER
STRAIN-SENSOR
MOTOR_DRIVER
Rate=1 --> 80 samples per second
LED
BURN
FDCAN
OSCILLATOR
MCU
POWER

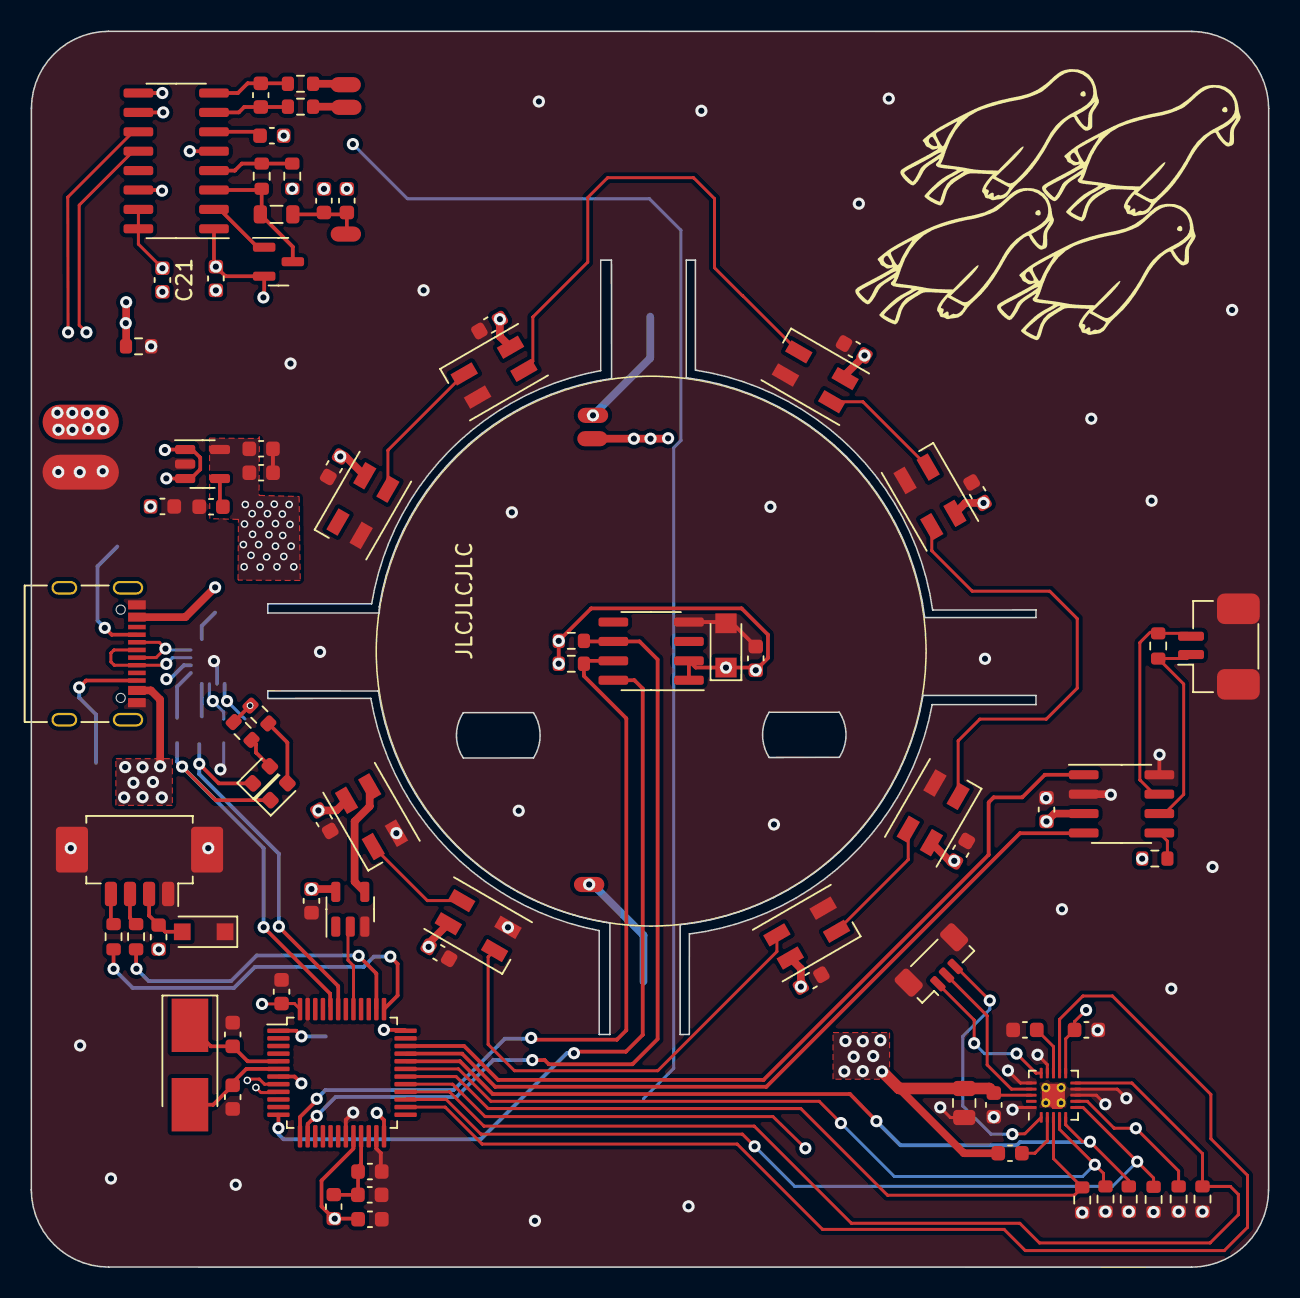
[picture p16: board gen1/ELEC3300_DEMO.kicad_pcb from above]

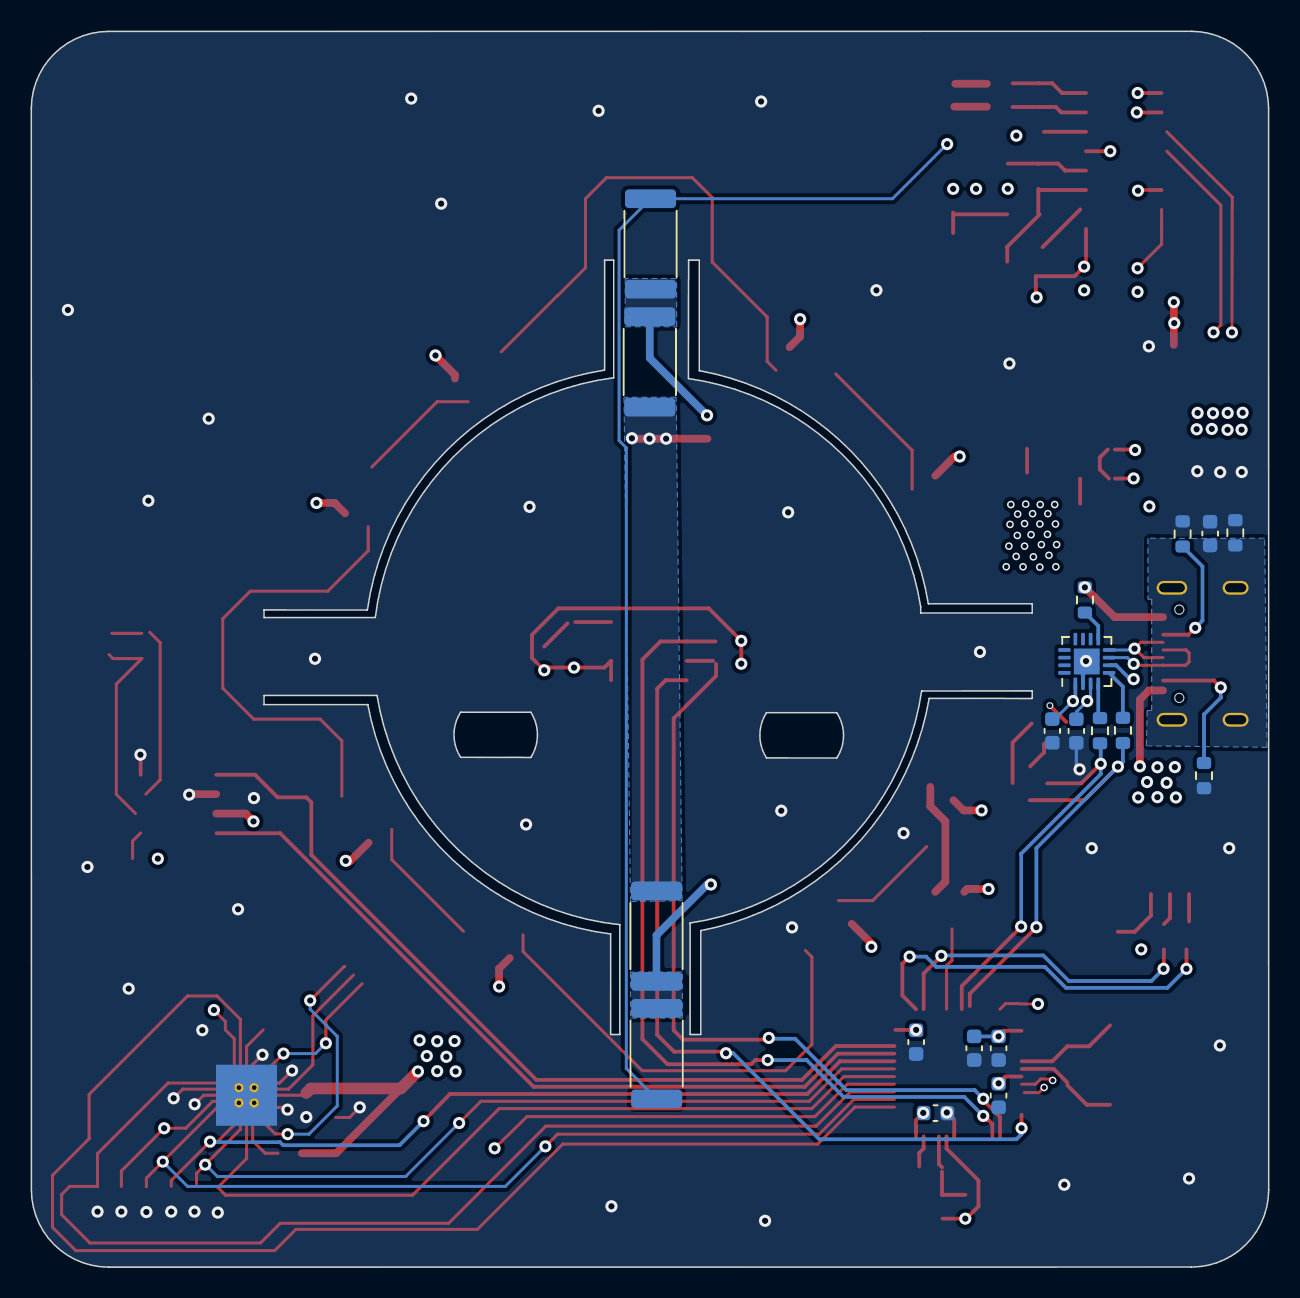
[picture p17: board gen1/ELEC3300_DEMO.kicad_pcb from below]

Board: 4 copper layers, 81.0 x 80.9 mm, 106 parts (19 on the bottom side), 69 nets.
