coopjz/FOC_Control_Boards/gen2/F407.ioc

Mcu.UserName=STM32F407VGTx
PA0-WKUP.Signal=UART4_TX
PA1.Signal=UART4_RX
PA10.Signal=USART1_RX
PA11.Signal=CAN1_RX
PA12.Signal=CAN1_TX
PA13.Signal=SYS_JTMS-SWDIO
PA14.Signal=SYS_JTCK-SWCLK
PA15.GPIO_Label=LED_DATA_3v3
PA15.Signal=S_TIM2_CH1_ETR
PA2.Signal=USART2_TX
PA3.Signal=USART2_RX
PA8.GPIO_Label=TP_SCL
PA8.Signal=I2C3_SCL
PA9.Signal=USART1_TX
PB10.Signal=I2C2_SCL
PB11.Signal=I2C2_SDA
PB13.Signal=SPI2_SCK
PB14.Signal=SPI2_MISO
PB15.Signal=SPI2_MOSI
PB3.Signal=SPI1_SCK
PB4.Signal=SPI1_MISO
PB5.Signal=SPI1_MOSI
PC10.Signal=SPI3_SCK
PC11.Signal=SPI3_MISO
PC12.Signal=SPI3_MOSI
PC6.Signal=USART6_TX
PC7.Signal=USART6_RX
PC9.GPIO_Label=TP_SDA
PC9.Signal=I2C3_SDA
PD0.Signal=GPIO_Output
PD1.Signal=GPIO_Output
PD10.GPIO_Label=LCD_CS
PD10.Signal=GPIO_Output
PD11.GPIO_Label=LCD_DC
PD11.Signal=GPIO_Output
PD12.GPIO_Label=LCD_RST
PD12.Signal=GPIO_Output
PD13.GPIO_Label=LCD_BL
PD13.Signal=GPIO_Output
PD14.GPIO_Label=TP_RST
PD14.Signal=GPIO_Output
PD15.GPIO_Label=TP_INT
PD15.Signal=GPIO_Input
PD7.GPIO_Label=MAG_CSN
PD7.Signal=GPIO_Output
PD8.Signal=USART3_TX
PD9.Signal=USART3_RX
PE10.Signal=TIM1_CH2N
PE11.Signal=S_TIM1_CH2
PE12.Signal=TIM1_CH3N
PE13.Signal=S_TIM1_CH3
PE14.Signal=GPIO_Input
PE8.Signal=TIM1_CH1N
PE9.Signal=S_TIM1_CH1
PH0-OSC_IN.Signal=RCC_OSC_IN
PH1-OSC_OUT.Signal=RCC_OSC_OUT
